Roborock-OpenSource/Cullinan/ApplySample.md

How to apply for samples?
====
Please fiil in this form:<br>
https://forms.gle/SxK5jUcbVehNAaGGA<br>

Sample looks like
====


3D
====


Output of CullinanDemo.py
====
