Roborock-OpenSource/Cullinan/src/main.c

/**
  ******************************************************************************
  * @file           : main.c
  * @brief          : Main program body
  ******************************************************************************
  ** This notice applies to any and all portions of this file
  * that are not between comment pairs USER CODE BEGIN and
  * USER CODE END. Other portions of this file, whether 
  * inserted by the user or by software development tools
  * are owned by their respective copyright owners.
  *
  * COPYRIGHT(c) 2018 STMicroelectronics
  *
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
  ******************************************************************************
  */
/* Includes ------------------------------------------------------------------*/
#include "main.h"
#include "usb_device.h"
#include "config.h"
#include "LDS.h"
#include "cmd.h"


/* USER CODE BEGIN PV */

/* USER CODE END PV */

void SystemClock_Config(void);
static void MX_GPIO_Init(void);
static void MX_TIM8_Init(void);
static void MX_SPI2_Init(void);
static void MX_UART5_Init(void);
static void MX_USART3_Init(void);
static void MX_TIM2_Init(void);
static void MX_NVIC_Init(void);

/* USER CODE BEGIN PFP */

void IMU(void);


extern uint8_t UART5_RecvBuf[UART5_RECV_BUF_SIZE];
extern uint8_t UART5_SendBuf[UART5_SEND_BUF_SIZE];
extern uint8_t *UART5_RecvHead;
extern uint8_t *UART5_RecvTail;
extern uint8_t * volatile UART5_SendTail;
extern uint8_t *UART5_SendHead;

extern uint32_t SpeedTimer;

extern uint32_t DebugOn;

void SerialInit(void)
{
    UART5_RecvHead = UART5_RecvBuf;
    UART5_RecvTail = UART5_RecvBuf;
    UART5_SendHead = UART5_SendBuf;
    UART5_SendTail = UART5_SendBuf;
}


  
/**
  * @brief  The application entry point.
  *
  * @retval None
  */
int main(void)
{

  /* MCU Configuration */

  /* Reset of all peripherals, Initializes the Flash interface and the Systick. */
  HAL_Init();
  LL_APB2_GRP1_EnableClock(LL_APB2_GRP1_PERIPH_SYSCFG);

  /* Configure the system clock */
  SystemClock_Config();

  /* Initialize all configured peripherals */
  MX_GPIO_Init();

  MX_TIM8_Init();
  MX_SPI2_Init();

    MX_USART3_Init();
    MX_UART5_Init();
  MX_TIM2_Init();
  MX_USB_DEVICE_Init();

  /* Initialize interrupts */
  MX_NVIC_Init();
    SerialInit();

    LDS_PID_Init(0.004428f, 0.000214f, 0.028007f);
    SpeedTimer = 10; // speed sample time 10 ms
    CmdInit();
    
    TRACE("Cullinan FW v0.2\n");
    TRACE("Built at " __DATE__ " " __TIME__ "\n\n");
    
    DebugOn = 1;
    
    while (1)
    {
        if (!DebugOn)
        {
            lds();
            IMU();
        }
        cmd();
    }
}

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
