Roborock-OpenSource/Cullinan/(commit log)

2018-12-15 1 don't check index value because the new LDS device will send special index which out of range of 0xa0~0xf9 2 use previous value if no speed data within a sample period
2020-07-13 Use print() function in both Python 2 and Python 3
    Legacy __print__ statements are syntax errors in Python 3 but __print()__ function works as expected in both Python 2 and Python 3.
    Python 2 died on 1/1/2020.
    [CullinanDemo.py]
