Roborock-OpenSource/Cullinan/(notices)

Notices in the files:
src/main.c:
(C) COPYRIGHT STMicroelectronics *****END OF FILE
